RizkiMaulanaP/V2V_LoRa_CAN/BeamNG.tech/current/screenshots/2026-06/screenshot_2026-06-13_16-57-05.png

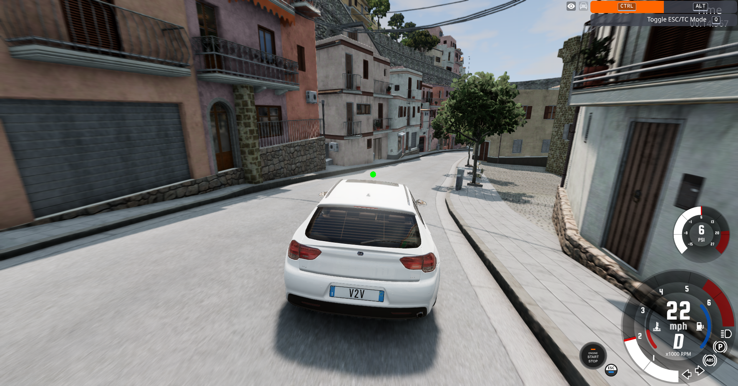
BeamNG.tech/current/screenshots/2026-06/screenshot_2026-06-13_16-57-05.png
