RizkiMaulanaP/V2V_LoRa_CAN/Flutter-App/v2v/assets/car.png

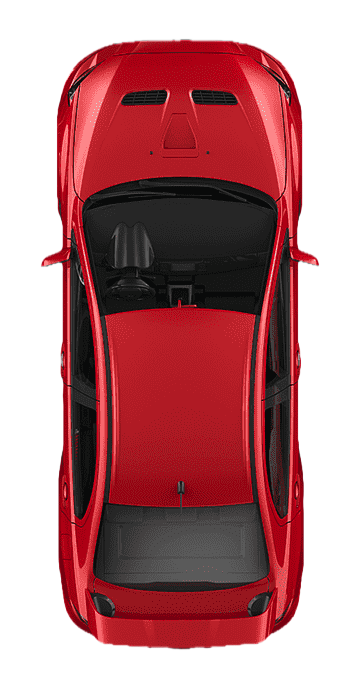
Flutter-App/v2v/assets/car.png
