RizkiMaulanaP/V2V_LoRa_CAN/Flutter-App/v2v/assets/car_fromTop.png

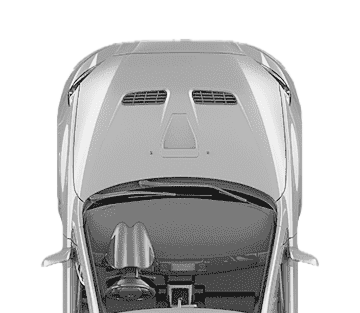
Flutter-App/v2v/assets/car_fromTop.png
