RizkiMaulanaP/V2V_LoRa_CAN/Flutter-App/v2v/assets/car_top.png

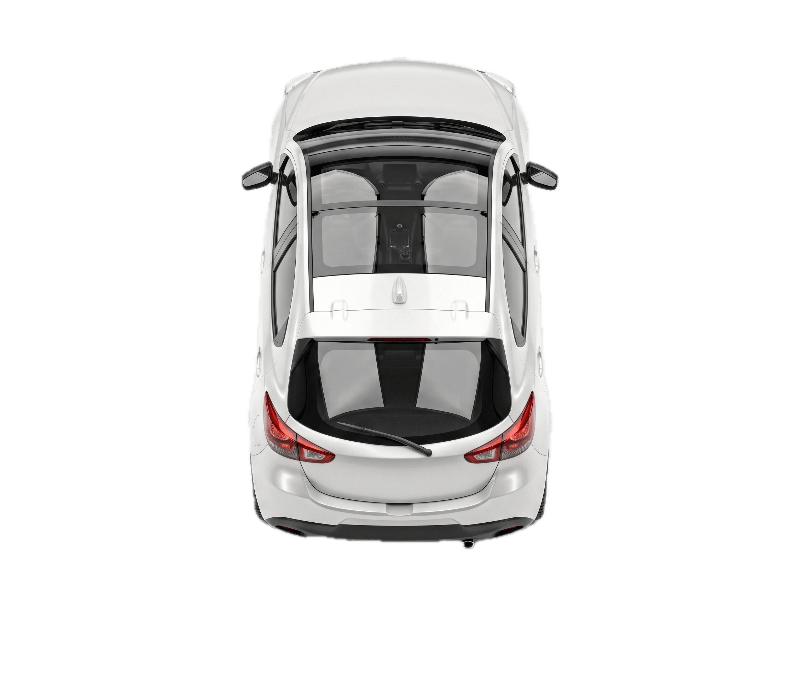
Flutter-App/v2v/assets/car_top.png
