RizkiMaulanaP/V2V_LoRa_CAN/Flutter-App/v2v/assets/fortuner_top.png

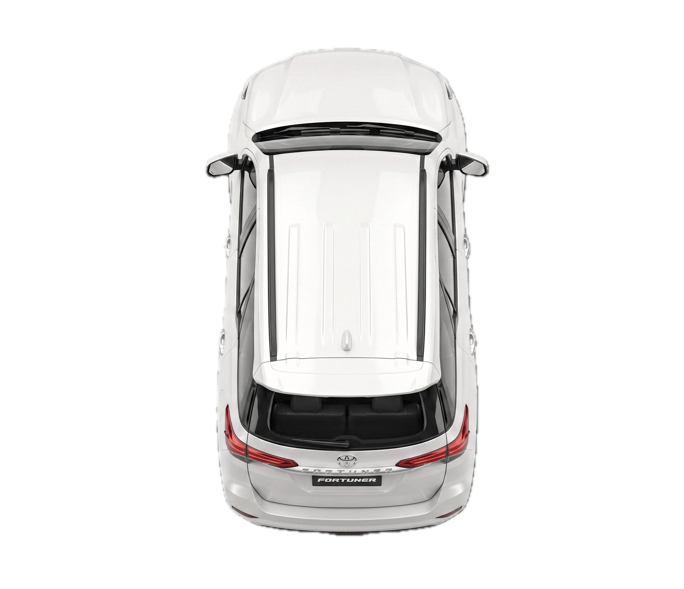
Flutter-App/v2v/assets/fortuner_top.png
