RizkiMaulanaP/V2V_LoRa_CAN/python-app/processed_20260611_160408.png

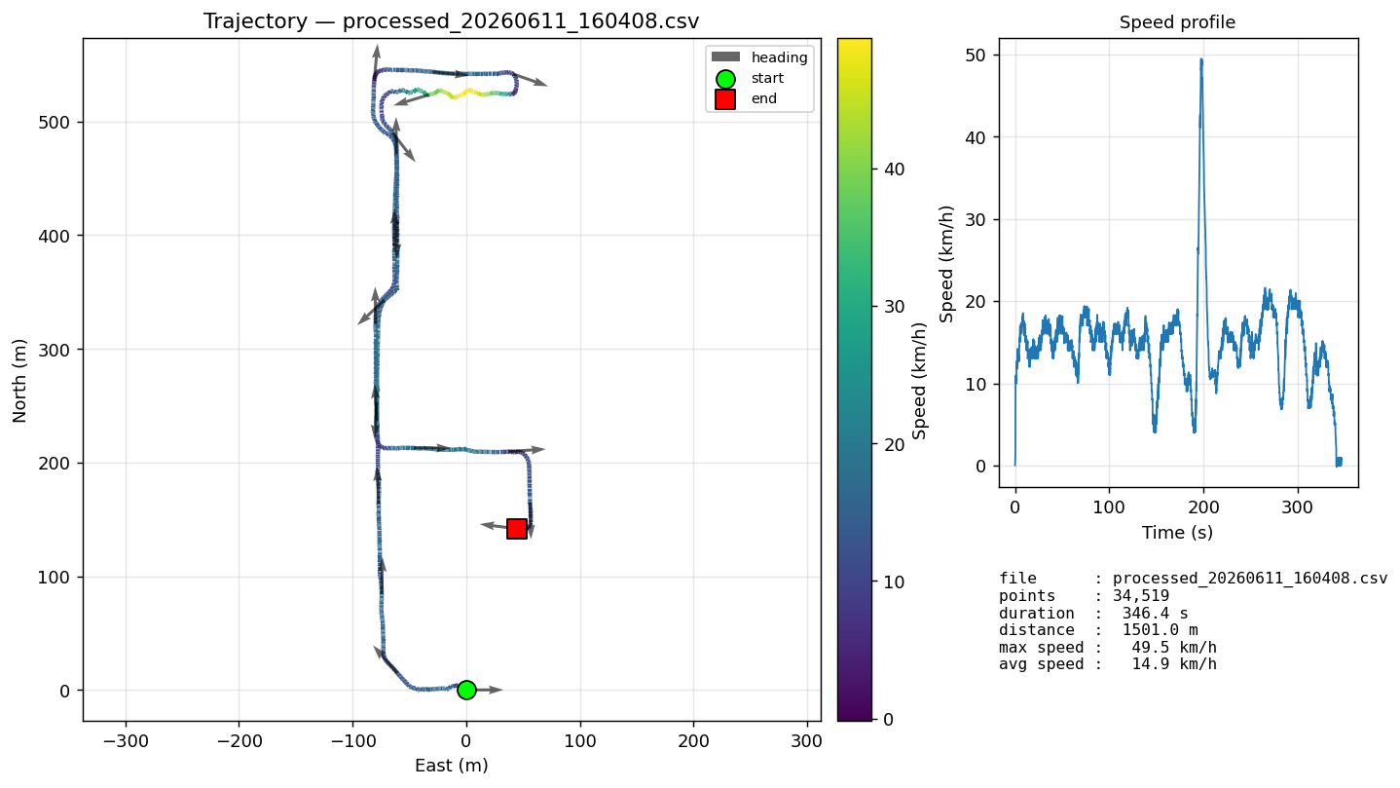
python-app/processed_20260611_160408.png
