RizkiMaulanaP/V2V_LoRa_CAN/python-app/processed_20260612_182122.png

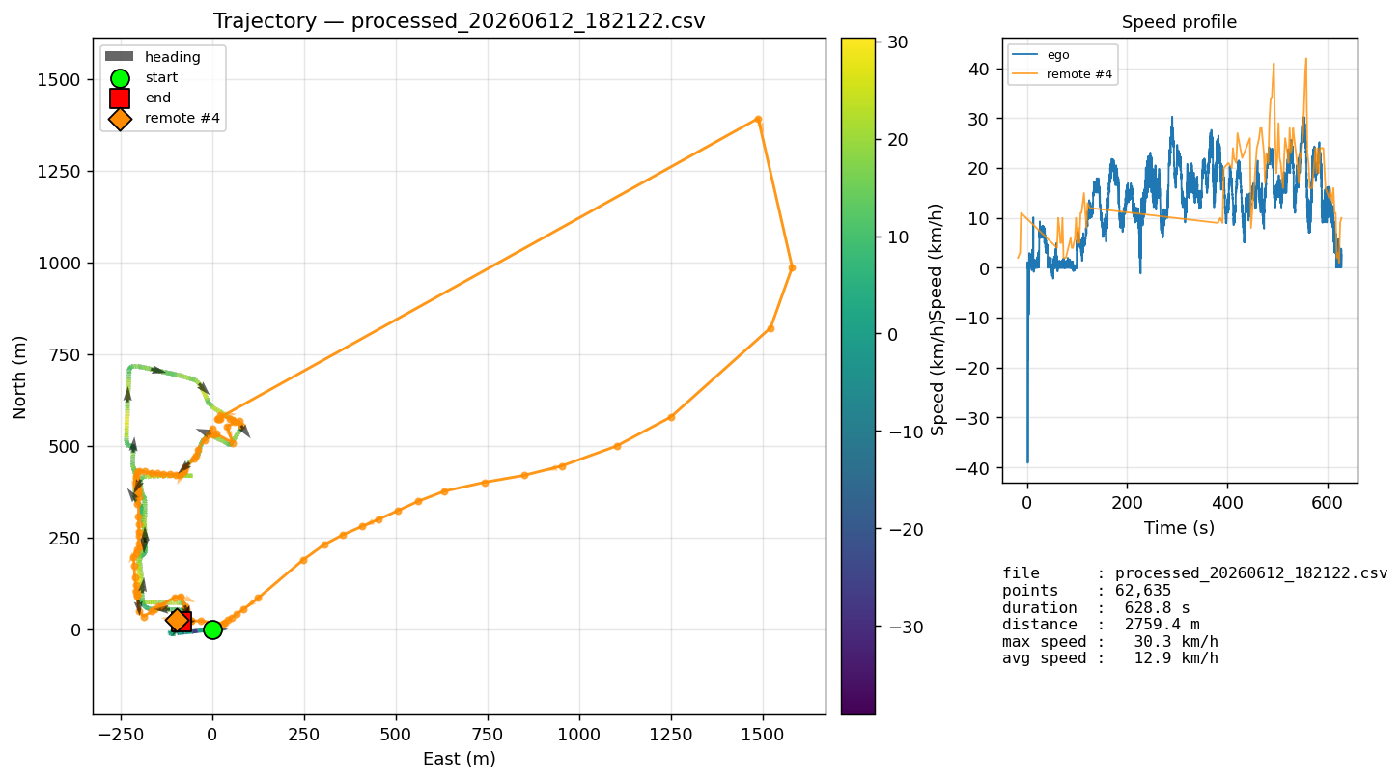
python-app/processed_20260612_182122.png
