RizkiMaulanaP/V2V_LoRa_CAN/python-app/processed_20260613_155110.png

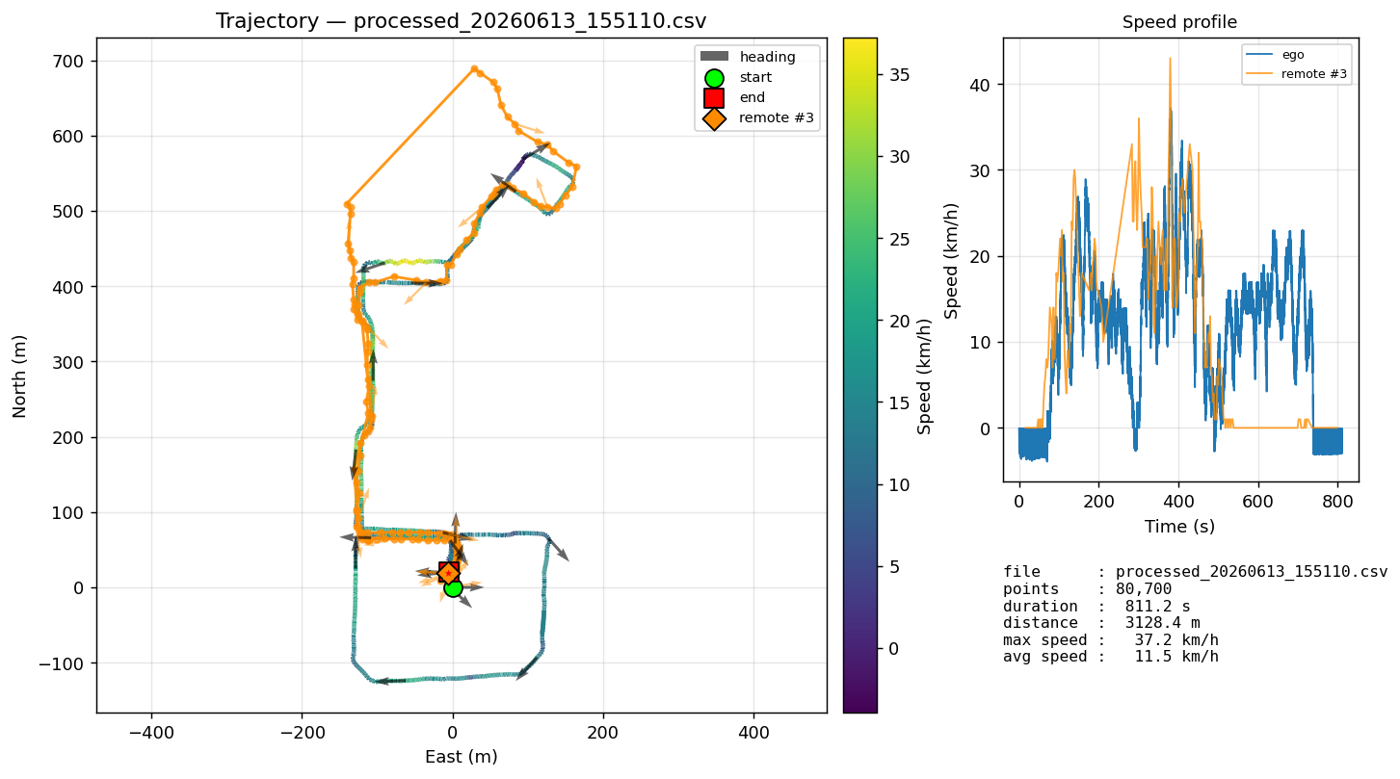
python-app/processed_20260613_155110.png
