RizkiMaulanaP/V2V_LoRa_CAN/python-app/processed_20260613_155125.png

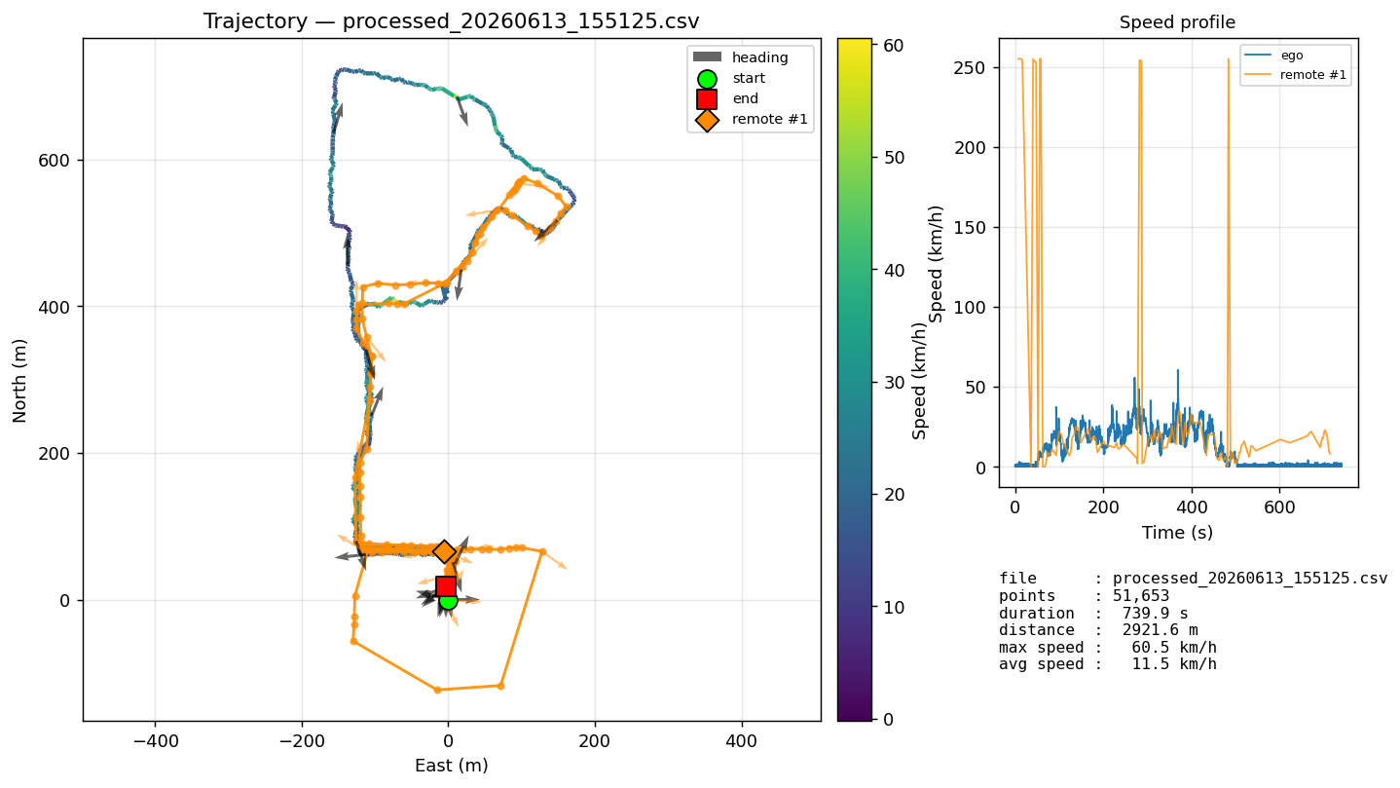
python-app/processed_20260613_155125.png
