RizkiMaulanaP/V2V_LoRa_CAN/python-app/processed_20260615_162513.png

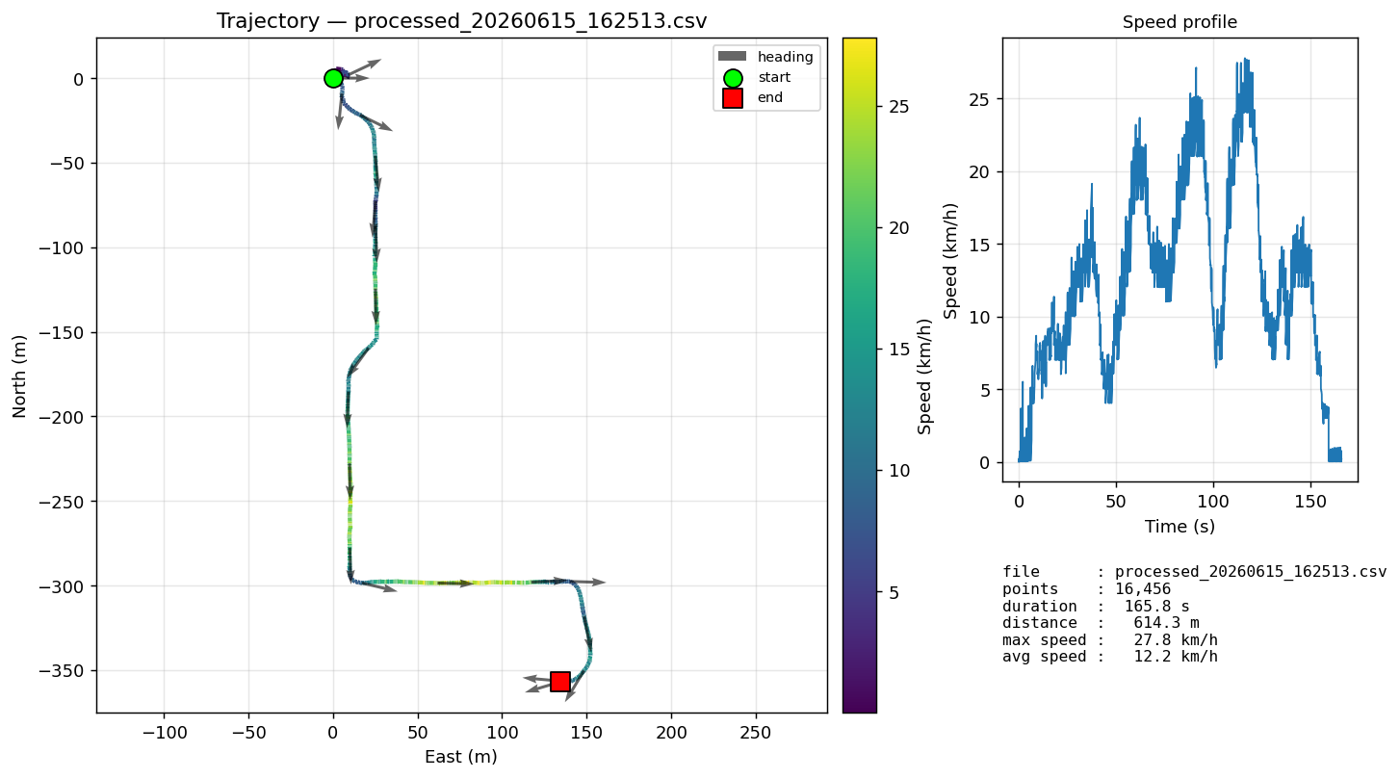
python-app/processed_20260615_162513.png
