RizkiMaulanaP/V2V_LoRa_CAN/python-app/processed_20260615_164056.png

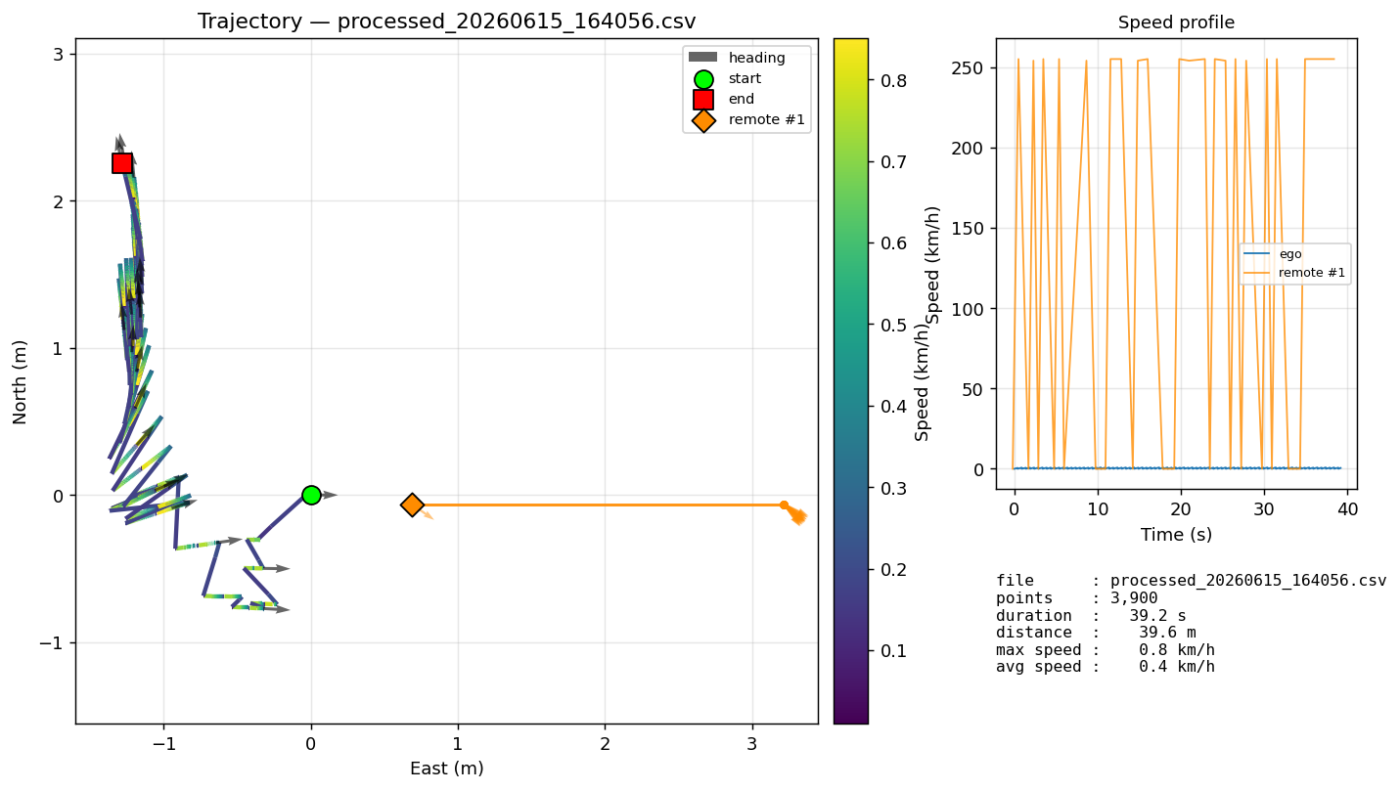
python-app/processed_20260615_164056.png
