RizkiMaulanaP/V2V_LoRa_CAN/v2v-proto/V2V Proto Board.step

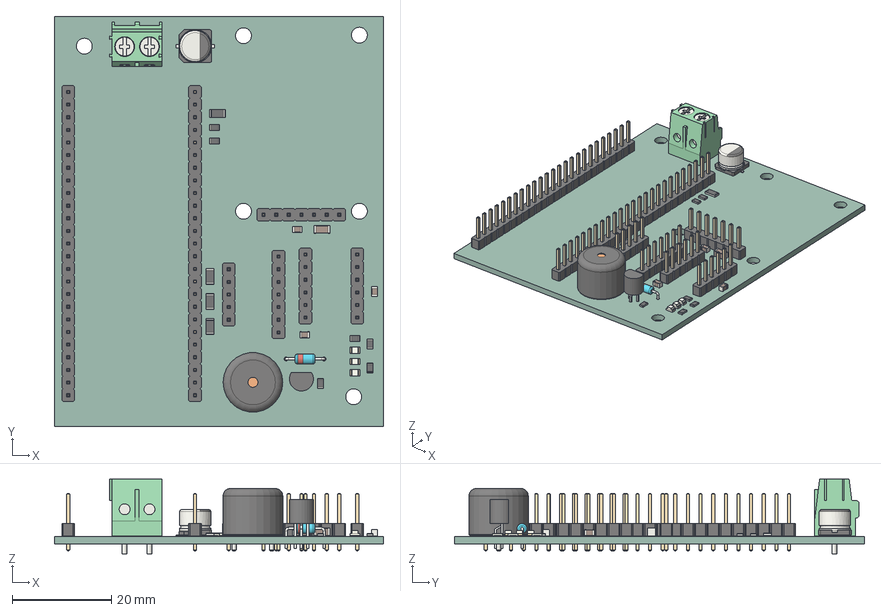
[picture p15: CAD file, 2026-06-15]
v2v-proto/V2V Proto Board.step
66.2 x 82.5 x 15.0 mm
PinHeader_1x07_P2.54mm_Vertical x 2
C_1206_3216Metric
C_0805_2012Metric x 3
R_0805_2012Metric x 6
LED_0805_2012Metric x 3
R_1206_3216Metric x 4
PinHeader_1x05_P2.54mm_Vertical
TO-92
PinHeader_1x06_P2.54mm_Vertical x 2
PinHeader_1x25_P2.54mm_Vertical x 2
TerminalBlock_Phoenix_PT-1,5-2-5.0-H_1x02_P5.00mm_Horizontal
CP_Elec_6.3x5.3
Buzzer_12x9.5RM7.6
D_DO-35_SOD27_P7.62mm_Horizontal
v2v-proto_PCB
