RizkiMaulanaP/V2V_LoRa_CAN/v2v-proto/v2v-proto.kicad_pcb

## KiCad design v2v-proto/v2v-proto.kicad_pcb (2026-06-15)

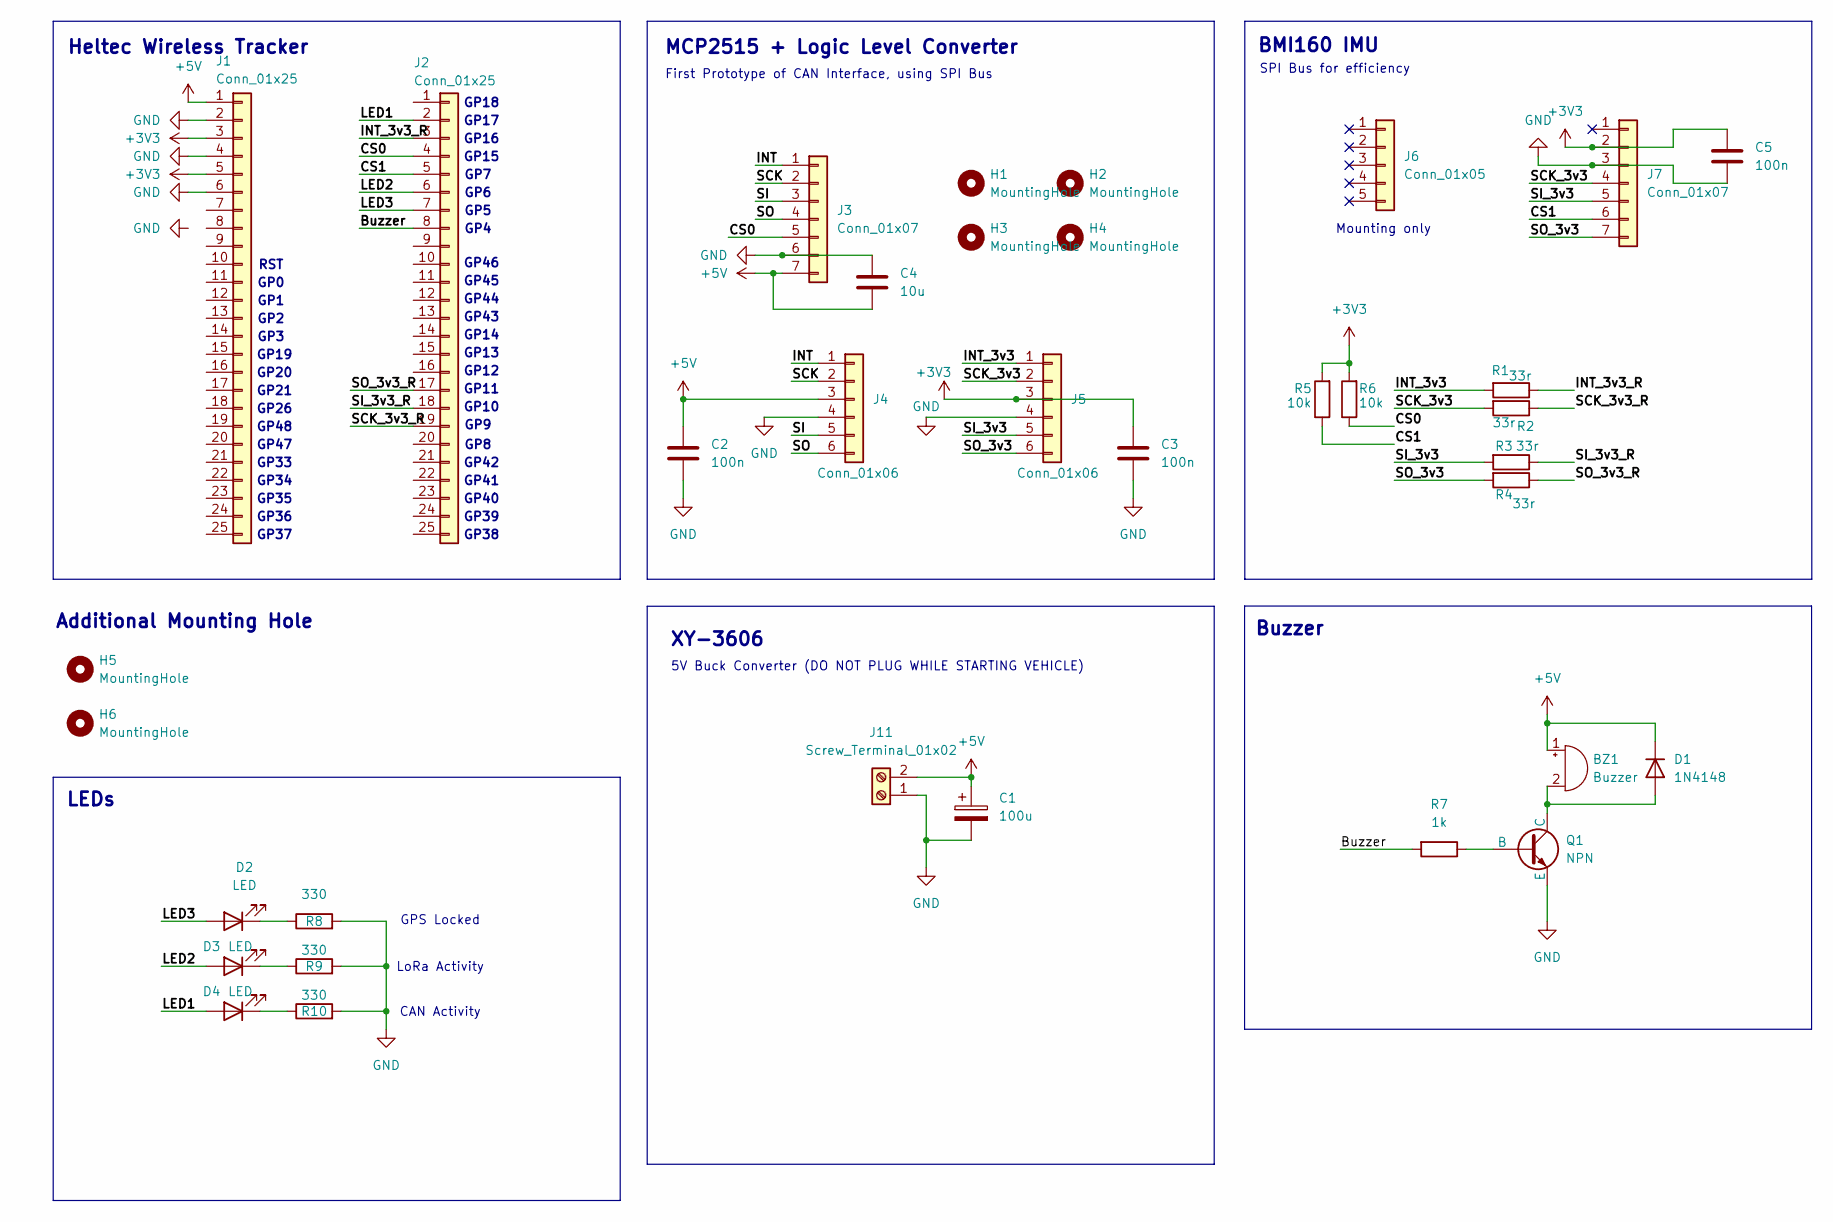
[picture p16: schematic v2v-proto.kicad_sch]

Parts:
BZ1: Buzzer; Buzzer_12x9.5RM7.6
C1: 100u; CP_Elec_6.3x5.3
C2, C3, C5: 100n; C_0805_2012Metric_Pad1.18x1.45mm_HandSolder
C4: 10u; C_1206_3216Metric_Pad1.33x1.80mm_HandSolder
D1: 1N4148; D_DO-35_SOD27_P7.62mm_Horizontal
D2, D3, D4: LED; LED_0805_2012Metric
H1, H2, H3, H4, H5, H6: MountingHole; MountingHole_3.2mm_M3
J1, J2: Conn_01x25; PinHeader_1x25_P2.54mm_Vertical
J3, J7: Conn_01x07; PinHeader_1x07_P2.54mm_Vertical
J4, J5: Conn_01x06; PinHeader_1x06_P2.54mm_Vertical
J6: Conn_01x05; PinHeader_1x05_P2.54mm_Vertical
J11: Screw_Terminal_01x02; TerminalBlock_MaiXu_MX126-5.0-02P_1x02_P5.00mm
Q1: NPN; TO-92
R1, R2, R3, R4: 33r; R_1206_3216Metric_Pad1.30x1.75mm_HandSolder
R5, R6: 10k; R_0805_2012Metric_Pad1.20x1.40mm_HandSolder
R7: 1k; R_0805_2012Metric_Pad1.20x1.40mm_HandSolder
R8, R9, R10: 330; R_0805_2012Metric_Pad1.20x1.40mm_HandSolder

Connections:
+3V3: C3.1, C5.1, J1.3, J1.5, J5.3, J7.2, R5.2, R6.2
+5V: BZ1.1 (+), C1.1, C2.1, C4.1, D1.1 (K), J1.1, J3.7, J4.3, J11.2
/Buzzer: J2.8, R7.2
/CS0: J2.4, J3.5, R6.1
/CS1: J2.5, J7.6, R5.1
/INT: J3.1, J4.1
/INT_3v3: J5.1, R1.2
/INT_3v3_R: J2.3, R1.1
/LED1: D4.2 (A), J2.2
/LED2: D3.2 (A), J2.6
/LED3: D2.2 (A), J2.7
/SCK: J3.2, J4.2
/SCK_3v3: J5.2, J7.4, R2.2
/SCK_3v3_R: J2.19, R2.1
/SI: J3.3, J4.5
/SI_3v3: J5.5, J7.5, R3.2
/SI_3v3_R: J2.18, R3.1
/SO: J3.4, J4.6
/SO_3v3: J5.6, J7.7, R4.2
/SO_3v3_R: J2.17, R4.1
GND: C1.2, C2.2, C3.2, C4.2, C5.2, J1.2, J1.4, J1.6, J3.6, J4.4, J5.4, J7.3, J11.1, Q1.3 (E), R8.2, R9.2, R10.2
unnamed: BZ1.2 (-), D1.2 (A), Q1.1 (C)
unnamed: D2.1 (K), R8.1
unnamed: D3.1 (K), R9.1
unnamed: D4.1 (K), R10.1
unnamed: Q1.2 (B), R7.1

Notes on the sheet:
GP6
GP21
GP18
Additional Mounting Hole
CAN Activity
GP1
First Prototype of CAN Interface, using SPI Bus
GP48
GP7
GP39
GP26
GP44
GP14
GP17
GPS Locked
GP46
GP2
GP40
GP43
RST
GP38
XY-3606
GP20
GP35
Buzzer
GP37
GP3
GP41
LEDs
GP19
GP33
GP11
GP42
GP12
SPI Bus for efficiency
GP16
GP9
GP13
GP0
5V Buck Converter (DO NOT PLUG WHILE STARTING VEHICLE)
GP15
LoRa Activity
GP10
MCP2515 + Logic Level Converter
GP47
Heltec Wireless Tracker
GP5
BMI160 IMU
GP4
GP8
GP36
GP34
GP45
Mounting only

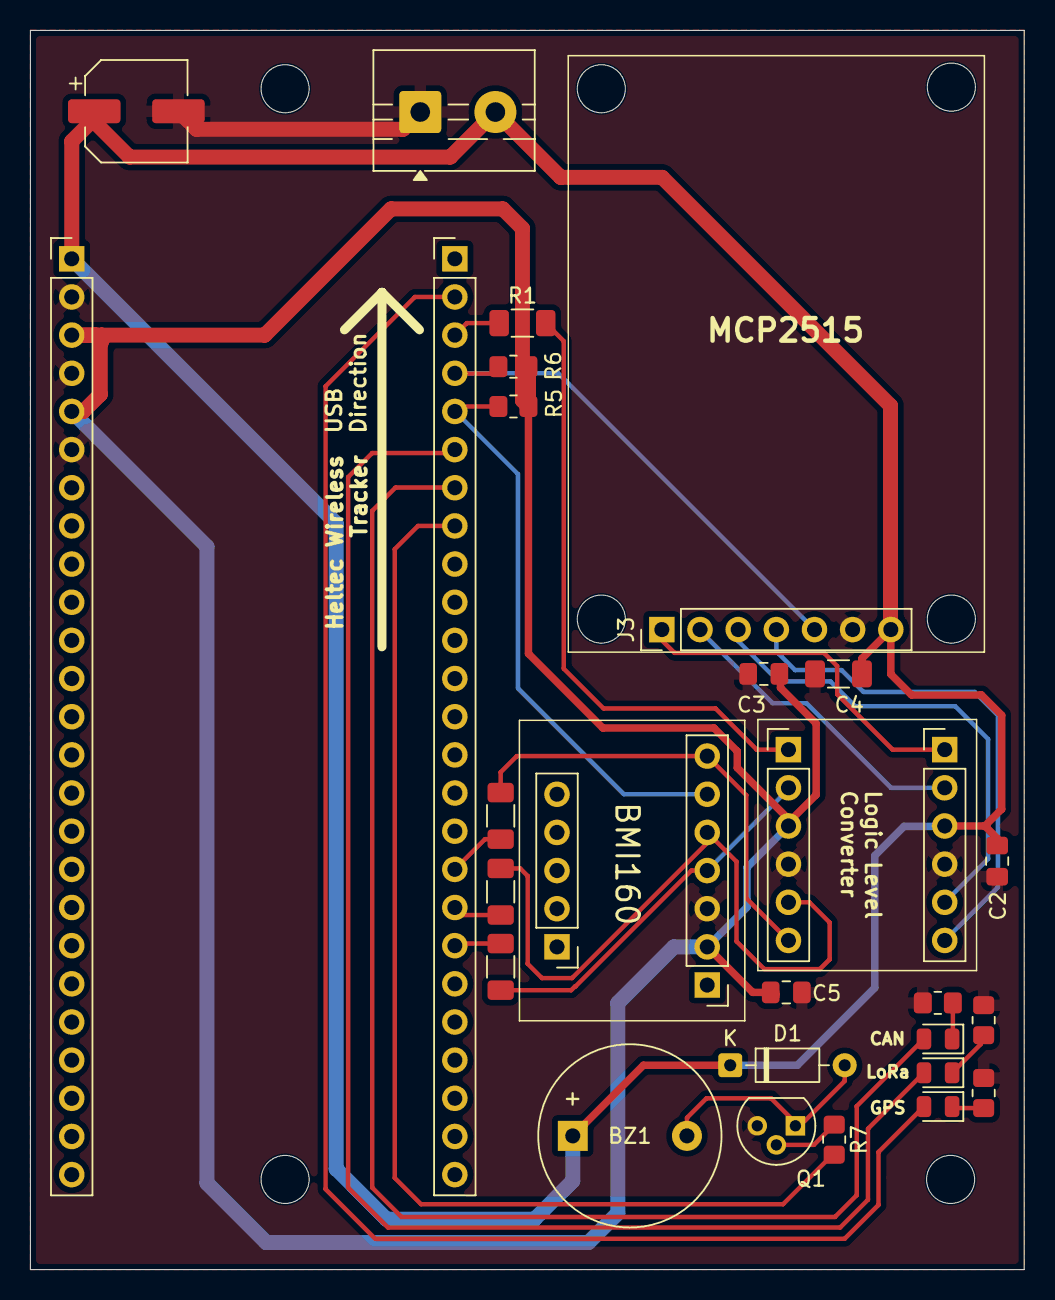
[picture p17: board v2v-proto.kicad_pcb from above]

Board: 2 copper layers, 66.2 x 82.5 mm, 36 parts (0 on the bottom side), 26 nets.

Other parts of the board:
H6#2: MountingHole; MountingHole_3.2mm_M3
