RizkiMaulanaP/V2V_LoRa_CAN/(commit log)

2026-06-15 Convert nested repositories to regular folders and track files
2026-06-15 Updated main_ukf.py
    [processed_20260615_162513.csv, processed_20260615_163302.csv, processed_20260615_164056.csv, raw_20260615_162513.csv, raw_20260615_163302.csv, raw_20260615_164056.csv]
